mfiumara/e1m-nea/hardware/data/README.md

# Pin data

| File | Source |
| --- | --- |
| `alif_e3_fbga194.json` | Extracted by `scripts/extract_alif_pins.py` from Alif ADTS0007 v2.12, Table 4-1, Table 4-2 and Figure 4-2 (factual pin data) |
| `pinmap.json` | `scripts/pinmap.py`: SoC ball allocation for every edge and on-module net |
| `edge_pinout.json` | `scripts/gen_edge.py`: this project's own 244-pad edge pinout |
| `logo/` | Fiumara Labs favicon and its silkscreen bitmap (`scripts/gen_logo.py`) |
