mfiumara/e1m-nea/docs/pinmap.md

# Pin allocation

Generated by `scripts/gen_docs.py` from `hardware/data/pinmap.json`. Do not edit.

114 edge nets and 33 on-module nets use Alif balls; 0 GPIO balls are left over. Not placed: DVP.

## Edge nets

| Edge pad | Net | Alif pin | Ball | Signal (mux) | Group |
| --- | --- | --- | --- | --- | --- |
| 64 | AIN0 | P0_0 | R19 | ANA_S0 (7) | AIN0 |
| 65 | AIN1 | P0_1 | R13 | ANA_S1 (7) | AIN1 |
| 66 | AIN2 | P0_2 | R12 | ANA_S2 (7) | AIN2 |
| 68 | AIN3 | P0_3 | R11 | ANA_S3 (7) | AIN3 |
| 69 | AIN4 | P0_4 | R10 | ANA_S4 (7) | AIN4 |
| 70 | AIN5 | P0_5 | N15 | ANA_S5 (7) | AIN5 |
| 60 | AOUT0 | P2_2 | J15 | ANA_S18 (7) | AOUT0 |
| 61 | AOUT1 | P2_3 | H15 | ANA_S19 (7) | AOUT1 |
| 45 | CAN_RXD | P12_4 | F5 | CAN_RXD_C (4) | CAN |
| 46 | CAN_STB | P12_6 | E5 | CAN_STBY_C (4) | CAN |
| 44 | CAN_TXD | P12_5 | A10 | CAN_TXD_C (4) | CAN |
| 15 | SWCLK | P4_4 | B17 | JTAG_TCK (1) | DEBUG |
| 14 | SWDIO | P4_5 | A19 | JTAG_TMS (1) | DEBUG |
| 16 | SWO | P4_7 | B16 | JTAG_TDO (1) | DEBUG |
| 17 | TDI | P4_6 | A18 | JTAG_TDI (1) | DEBUG |
| 142 | GPIO0 | P1_0 | R14 | GPIO1_0 (0) | GPIO |
| 143 | GPIO1 | P1_1 | M15 | GPIO1_1 (0) | GPIO |
| 150 | GPIO2 | P1_2 | L15 | GPIO1_2 (0) | GPIO |
| 151 | GPIO3 | P3_2 | E2 | GPIO3_2 (0) | GPIO |
| 164 | GPIO4 | P4_0 | F18 | GPIO4_0 (0) | GPIO |
| 165 | GPIO5 | P4_1 | B19 | GPIO4_1 (0) | GPIO |
| 167 | GPIO6 | P4_3 | B18 | GPIO4_3 (0) | GPIO |
| 168 | GPIO7 | P5_5 | E10 | GPIO5_5 (0) | GPIO |
| 169 | GPIO8 | P5_6 | B12 | GPIO5_6 (0) | GPIO |
| 172 | GPIO9 | P5_7 | B11 | GPIO5_7 (0) | GPIO |
| 173 | GPIO10 | P7_3 | A8 | GPIO7_3 (0) | GPIO |
| 183 | GPIO11 | P7_5 | T2 | GPIO7_5 (0) | GPIO |
| 190 | GPIO12 | P8_6 | J2 | GPIO8_6 (0) | GPIO |
| 191 | GPIO13 | P9_6 | K5 | GPIO9_6 (0) | GPIO |
| 192 | GPIO14 | P9_7 | L5 | GPIO9_7 (0) | GPIO |
| 194 | GPIO15 | P10_3 | N2 | GPIO10_3 (0) | GPIO |
| 195 | GPIO16 | P10_7 | P1 | GPIO10_7 (0) | GPIO |
| 196 | GPIO17 | P12_3 | D18 | GPIO12_3 (0) | GPIO |
| 197 | GPIO18 | P14_1 | H2 | GPIO14_1 (0) | GPIO |
| 198 | GPIO19 | P14_4 | R8 | GPIO14_4 (0) | GPIO |
| 199 | GPIO20 | P14_5 | L11 | GPIO14_5 (0) | GPIO |
| 201 | GPIO21 | P14_6 | K12 | GPIO14_6 (0) | GPIO |
| 202 | GPIO22 | P14_7 | L12 | GPIO14_7 (0) | GPIO |
| 203 | GPIO23 | P15_0 | V2 | GPIOV_0 (0) | GPIO |
| 204 | GPIO24 | P15_2 | U2 | GPIOV_2 (0) | GPIO |
| 230 | GPIO25 | P15_3 | V1 | GPIOV_3 (0) | GPIO |
| 231 | GPIO26 | P15_4 | V3 | GPIOV_4 (0) | GPIO |
| 232 | GPIO27 | P15_5 | W4 | GPIOV_5 (0) | GPIO |
| 233 | GPIO28 | P15_6 | V4 | GPIOV_6 (0) | GPIO |
| 234 | GPIO29 | P15_7 | W5 | GPIOV_7 (0) | GPIO |
| 42 | SD_CD | P4_2 | C19 | GPIO4_2 (0) | GPIO |
| 10 | WAKE_N | P15_1 | W2 | GPIOV_1 (0) | GPIO |
| 132 | I2C0_SCL | P7_1 | B3 | I2C0_SCL_C (4) | I2C0 |
| 133 | I2C0_SDA | P7_0 | B8 | I2C0_SDA_C (4) | I2C0 |
| 135 | I2C1_SCL | P3_7 | L8 | I2C1_SCL_B (5) | I2C1 |
| 136 | I2C1_SDA | P3_6 | V5 | I2C1_SDA_B (5) | I2C1 |
| 111 | I2S0_BCLK | P3_0 | B6 | I2S0_SCLK_A (4) | I2S0 |
| 113 | I2S0_DIN | P1_6 | L19 | I2S0_SDI_A (3) | I2S0 |
| 114 | I2S0_DOUT | P1_7 | J18 | I2S0_SDO_A (3) | I2S0 |
| 112 | I2S0_LRCLK | P3_1 | A6 | I2S0_WS_A (4) | I2S0 |
| 110 | I2S0_MCLK | P12_0 | F19 | AUDIO_CLK_C (2) | I2S0_MCLK |
| 121 | I3C0_SCL | P7_7 | U1 | I3C_SCL_D (6) | I3C0 |
| 122 | I3C0_SDA | P7_6 | U3 | I3C_SDA_D (6) | I3C0 |
| 116 | PDM_CLK0 | P6_1 | E9 | PDM_C0_C (3) | PDM |
| 118 | PDM_CLK1 | P6_3 | B10 | PDM_C1_C (4) | PDM |
| 117 | PDM_DAT0 | P6_0 | A12 | PDM_D0_C (3) | PDM |
| 119 | PDM_DAT1 | P6_2 | A11 | PDM_D1_C (4) | PDM |
| 72 | PWM0 | P7_4 | T1 | UT10_T0_B (6) | PWM0 |
| 73 | PWM1 | P10_1 | M1 | UT0_T1_C (4) | PWM1 |
| 74 | PWM2 | P10_0 | M2 | UT0_T0_C (4) | PWM2 |
| 75 | PWM3 | P7_2 | D1 | UT9_T0_B (6) | PWM3 |
| 76 | PWM4 | P6_4 | E8 | UT6_T0_B (5) | PWM4 |
| 77 | PWM5 | P5_4 | E11 | UT2_T0_B (5) | PWM5 |
| 79 | QEC0_A | P8_4 | B4 | QEC0_X_B (3) | QEC0 |
| 80 | QEC0_B | P8_5 | H1 | QEC0_Y_B (3) | QEC0 |
| 81 | QEC1_A | P3_3 | G2 | QEC1_X_A (5) | QEC1 |
| 82 | QEC1_B | P3_4 | F2 | QEC1_Y_A (6) | QEC1 |
| 35 | SD_CLK | P9_1 | K1 | SD_CLK_C (4) | SD |
| 37 | SD_CMD | P9_0 | K2 | SD_CMD_C (4) | SD |
| 38 | SD_DAT0 | P8_0 | B7 | SD_D0_C (5) | SD |
| 39 | SD_DAT1 | P8_1 | C2 | SD_D1_C (4) | SD |
| 40 | SD_DAT2 | P8_2 | C3 | SD_D2_C (5) | SD |
| 41 | SD_DAT3 | P8_3 | A7 | SD_D3_C (5) | SD |
| 107 | SPI0_CS0 | P5_2 | E12 | SPI0_SS0_B (4) | SPI0 |
| 108 | SPI0_CS1 | P3_5 | F1 | SPI0_SS1_B (4) | SPI0 |
| 106 | SPI0_MISO | P5_0 | A16 | SPI0_MISO_B (4) | SPI0 |
| 105 | SPI0_MOSI | P5_1 | B14 | SPI0_MOSI_B (4) | SPI0 |
| 104 | SPI0_SCK | P5_3 | B13 | SPI0_SCLK_B (3) | SPI0 |
| 228 | SPI1_CS0 | P2_7 | J19 | SPI1_SS0_A (3) | SPI1 |
| 227 | SPI1_MISO | P2_4 | G19 | SPI1_MISO_A (3) | SPI1 |
| 226 | SPI1_MOSI | P2_5 | H19 | SPI1_MOSI_A (3) | SPI1 |
| 225 | SPI1_SCK | P2_6 | H18 | SPI1_SCLK_A (3) | SPI1 |
| 140 | UART0_CTS | P6_6 | E6 | UART0_CTS_B (2) | UART0 |
| 139 | UART0_RTS | P6_7 | A9 | UART0_RTS_B (2) | UART0 |
| 138 | UART0_RX | P1_4 | M19 | UART0_RX_B (2) | UART0 |
| 137 | UART0_TX | P1_5 | L18 | UART0_TX_B (2) | UART0 |
| 161 | UART1_RX | P12_1 | E18 | UART4_RX_B (2) | UART1 |
| 160 | UART1_TX | P12_2 | E15 | UART4_TX_B (2) | UART1 |
| 163 | UART2_RX | P2_0 | K19 | UART2_RX_B (2) | UART2 |
| 162 | UART2_TX | P2_1 | K18 | UART2_TX_B (2) | UART2 |
| 13 | CONSOLE_RX | SEUART_RX | A14 | SEUART_RX | dedicated |
| 12 | CONSOLE_TX | SEUART_TX | A13 | SEUART_TX | dedicated |
| 85 | CSI_CLK_N | MIPICSI_C_N | V16 | MIPICSI_C_N | dedicated |
| 84 | CSI_CLK_P | MIPICSI_C_P | W16 | MIPICSI_C_P | dedicated |
| 88 | CSI_D0_N | MIPICSI_0_N | V14 | MIPICSI_0_N | dedicated |
| 87 | CSI_D0_P | MIPICSI_0_P | W14 | MIPICSI_0_P | dedicated |
| 91 | CSI_D1_N | MIPICSI_1_N | V15 | MIPICSI_1_N | dedicated |
| 90 | CSI_D1_P | MIPICSI_1_P | W15 | MIPICSI_1_P | dedicated |
| 18 | DBG_NRST | NSRST | J12 | NSRST | dedicated |
| 96 | DSI_CLK_N | MIPIDSI_C_N | V10 | MIPIDSI_C_N | dedicated |
| 95 | DSI_CLK_P | MIPIDSI_C_P | W10 | MIPIDSI_C_P | dedicated |
| 99 | DSI_D0_N | MIPIDSI_0_N | V11 | MIPIDSI_0_N | dedicated |
| 98 | DSI_D0_P | MIPIDSI_0_P | W11 | MIPIDSI_0_P | dedicated |
| 102 | DSI_D1_N | MIPIDSI_1_N | V9 | MIPIDSI_1_N | dedicated |
| 101 | DSI_D1_P | MIPIDSI_1_P | W9 | MIPIDSI_1_P | dedicated |
| 24 | USB_DN | USB_DM | V7 | USB_DM | dedicated |
| 23 | USB_DP | USB_DP | W7 | USB_DP | dedicated |
| 21 | USB_ID | USB_IO_ID | R9 | USB_IO_ID | dedicated |
| 20 | USB_VBUS | USB_VBUS | W6 | USB_VBUS | dedicated |

## On-module nets

| Net | Alif pin | Ball | Signal (mux) |
| --- | --- | --- | --- |
| ETH_RMII.CRS_DV | P11_5 | J9 | ETH_CRS_DV_B (6) |
| ETH_RMII.IRQ | P11_7 | L9 | ETH_IRQ_B (6) |
| ETH_RMII.MDC | P11_2 | R2 | ETH_MDC_B (6) |
| ETH_RMII.MDIO | P11_1 | R1 | ETH_MDIO_B (5) |
| ETH_RMII.REFCLK | P11_0 | P2 | ETH_REFCLK_B (6) |
| ETH_RMII.RST | P11_6 | R6 | ETH_RST_B (6) |
| ETH_RMII.RXD0 | P11_3 | R5 | ETH_RXD0_B (6) |
| ETH_RMII.RXD1 | P11_4 | K8 | ETH_RXD1_B (6) |
| ETH_RMII.TXD0 | P10_4 | M5 | ETH_TXD0_B (6) |
| ETH_RMII.TXD1 | P10_5 | N5 | ETH_TXD1_B (6) |
| ETH_RMII.TXEN | P10_6 | P5 | ETH_TXEN_B (6) |
| OSPI_MEM.D0 | P13_0 | G18 | OSPI1_D0_B (1) |
| OSPI_MEM.D1 | P13_1 | G15 | OSPI1_D1_B (1) |
| OSPI_MEM.D2 | P13_2 | F15 | OSPI1_D2_B (1) |
| OSPI_MEM.D3 | P13_3 | E13 | OSPI1_D3_B (1) |
| OSPI_MEM.D4 | P13_4 | E14 | OSPI1_D4_B (1) |
| OSPI_MEM.D5 | P13_5 | A17 | OSPI1_D5_B (1) |
| OSPI_MEM.D6 | P13_6 | B15 | OSPI1_D6_B (1) |
| OSPI_MEM.D7 | P13_7 | A15 | OSPI1_D7_B (1) |
| OSPI_MEM.RXDS | P12_7 | D2 | OSPI1_RXDS_B (1) |
| OSPI_MEM.SCLK | P14_0 | B9 | OSPI1_SCLK_B (1) |
| OSPI_MEM.SS0 | P14_2 | G1 | OSPI1_SS0_B (1) |
| OSPI_MEM.SS1 | P14_3 | R7 | OSPI1_SS1_B (1) |
| PMIC_I2C.SCL | P0_6 | P15 | I2C2_SCL_A (4) |
| PMIC_I2C.SDA | P0_7 | R15 | I2C2_SDA_A (4) |
| PMIC_nINT | P10_2 | N1 | GPIO10_2 (0) |
| SD_PWR_EN | P1_3 | K15 | GPIO1_3 (0) |
| WIFI_IRQ | P6_5 | E7 | GPIO6_5 (0) |
| WIFI_SPI.CS | P9_5 | L1 | SPI2_SS0_B (3) |
| WIFI_SPI.MISO | P9_2 | G5 | SPI2_MISO_B (3) |
| WIFI_SPI.MOSI | P9_3 | H5 | SPI2_MOSI_B (4) |
| WIFI_SPI.SCLK | P9_4 | J5 | SPI2_SCLK_B (3) |
| WIFI_nRESET | P8_7 | J1 | GPIO8_7 (0) |
