mfiumara/e1m-nea/docs/images/floorplan-revA-top.png

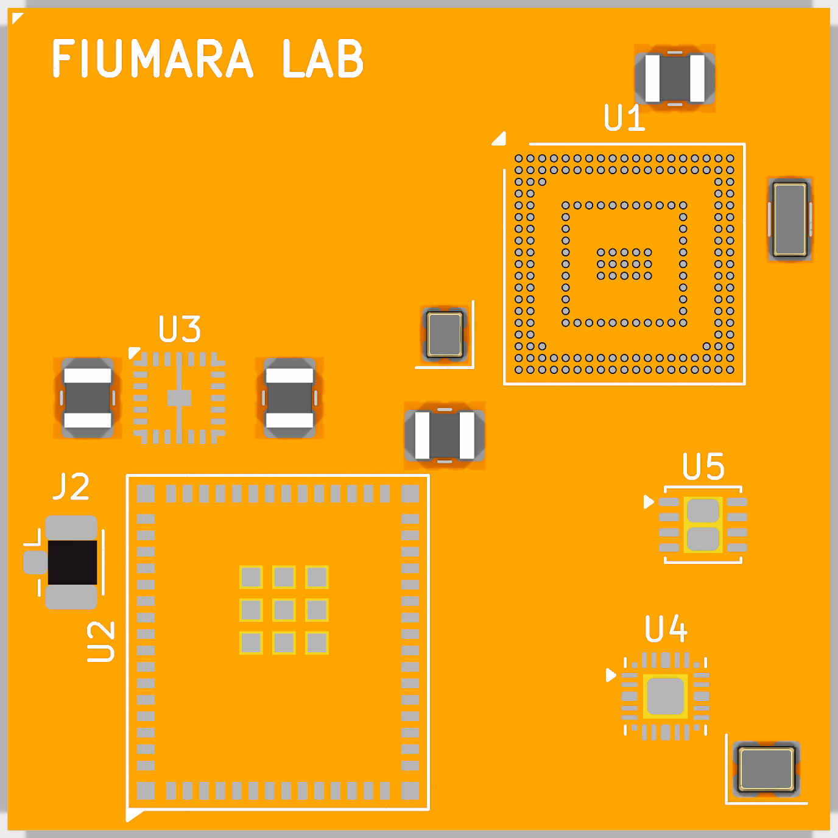
docs/images/floorplan-revA-top.png
